frubem/Delta_Redux_KB/docs/kb_II.pdf

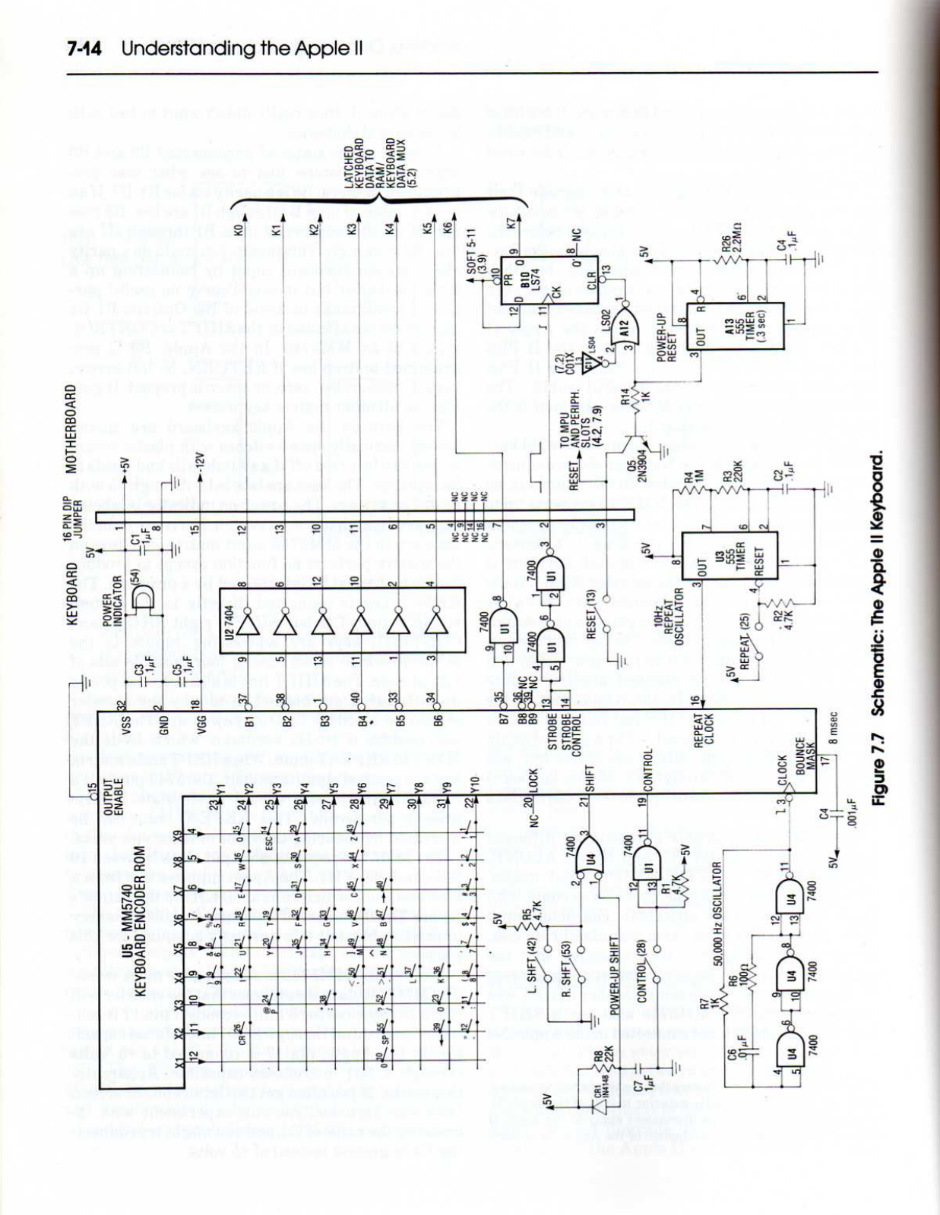
[picture p2: page 1]
