frubem/Delta_Redux_KB/docs/kb_IIp.pdf

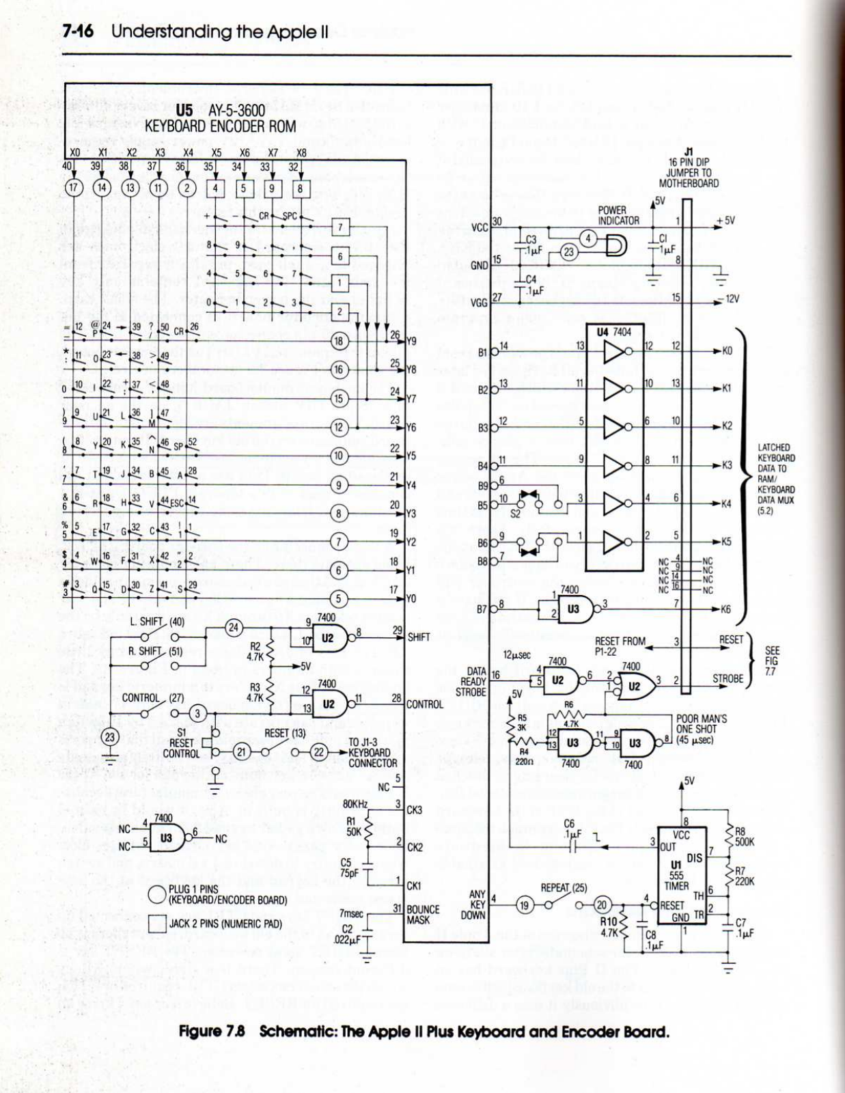
[picture p3: page 1]
