frubem/Delta_Redux_KB/docs/scancodes.pdf

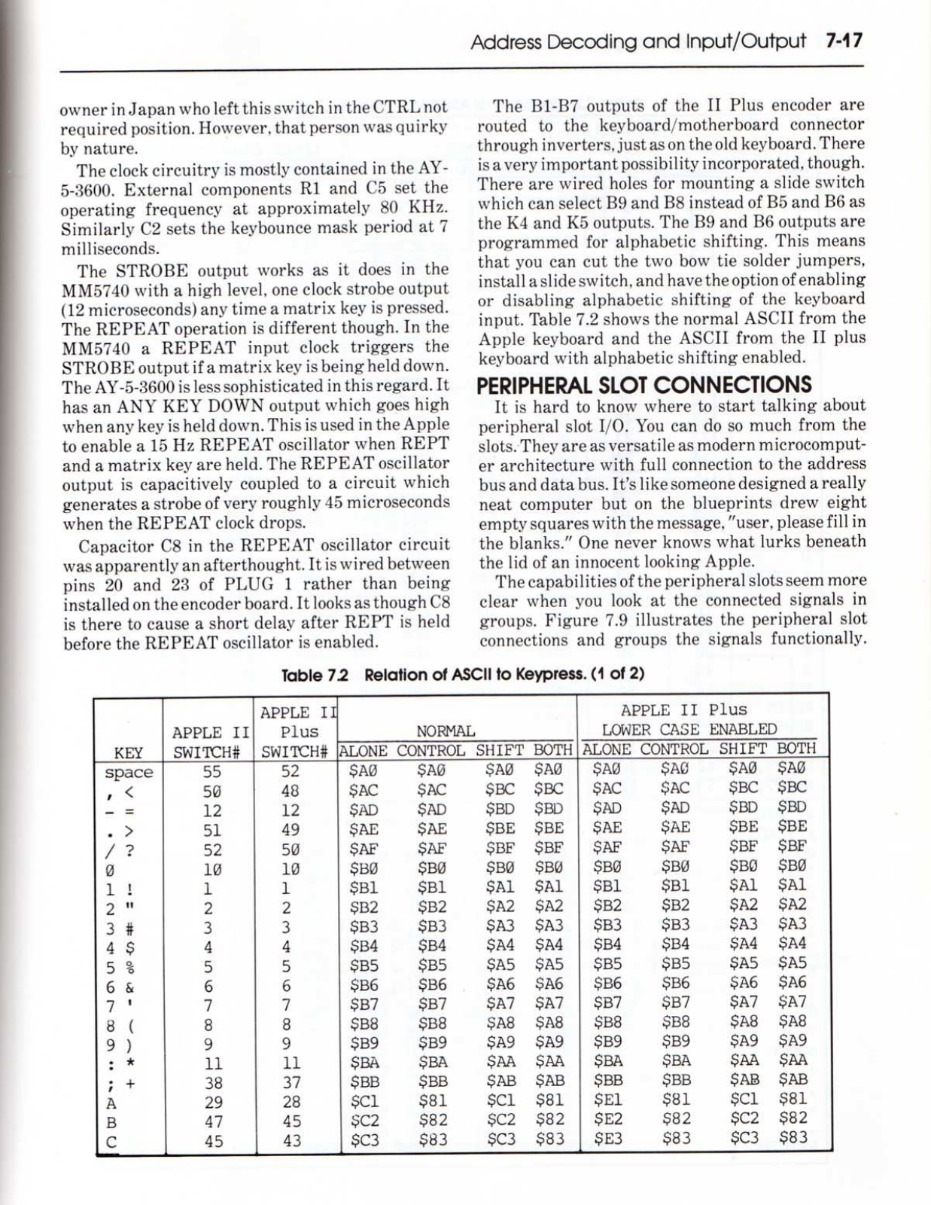
[picture p4: page 1]
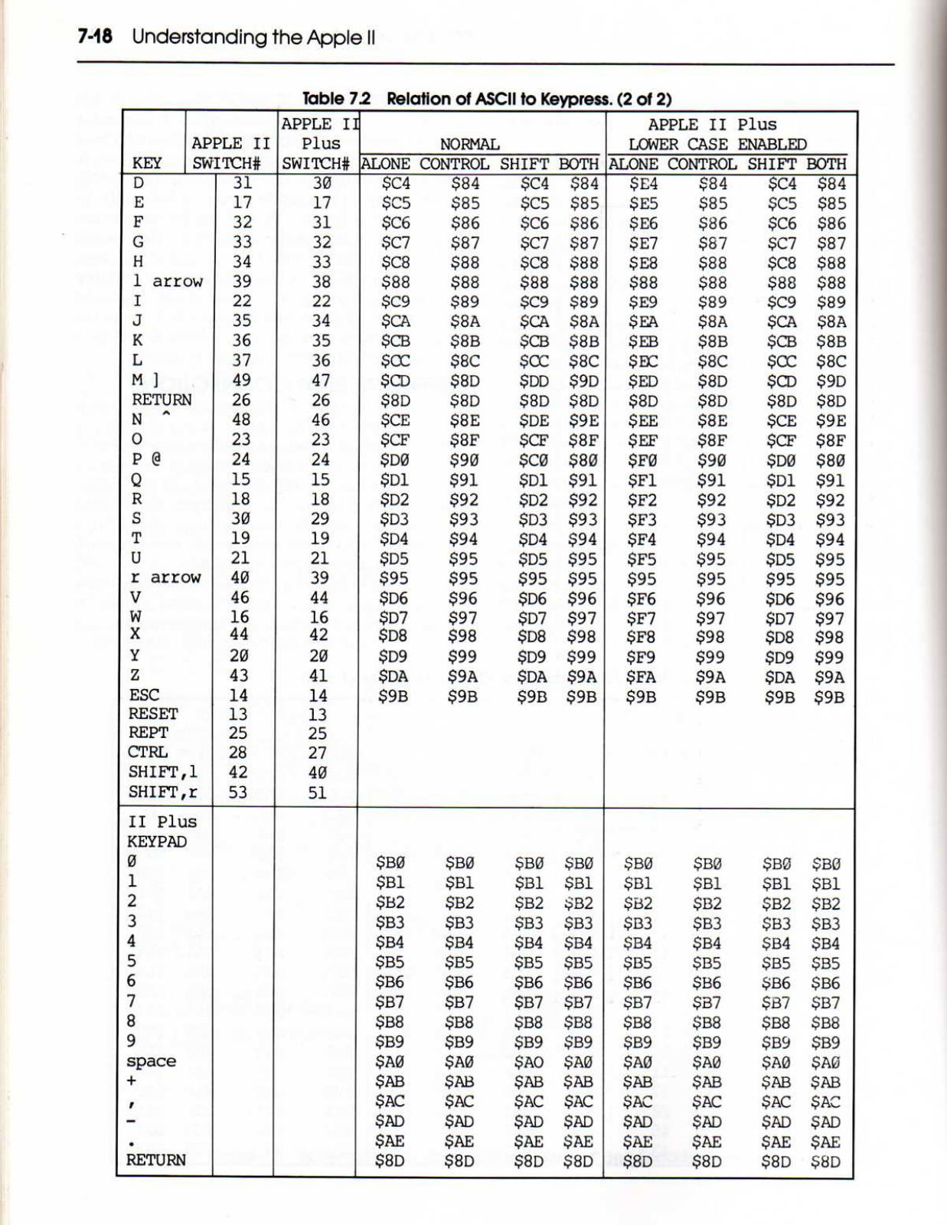
[picture p5: page 2]
