frubem/Delta_Redux_KB/docs/scancodes_IIe.pdf

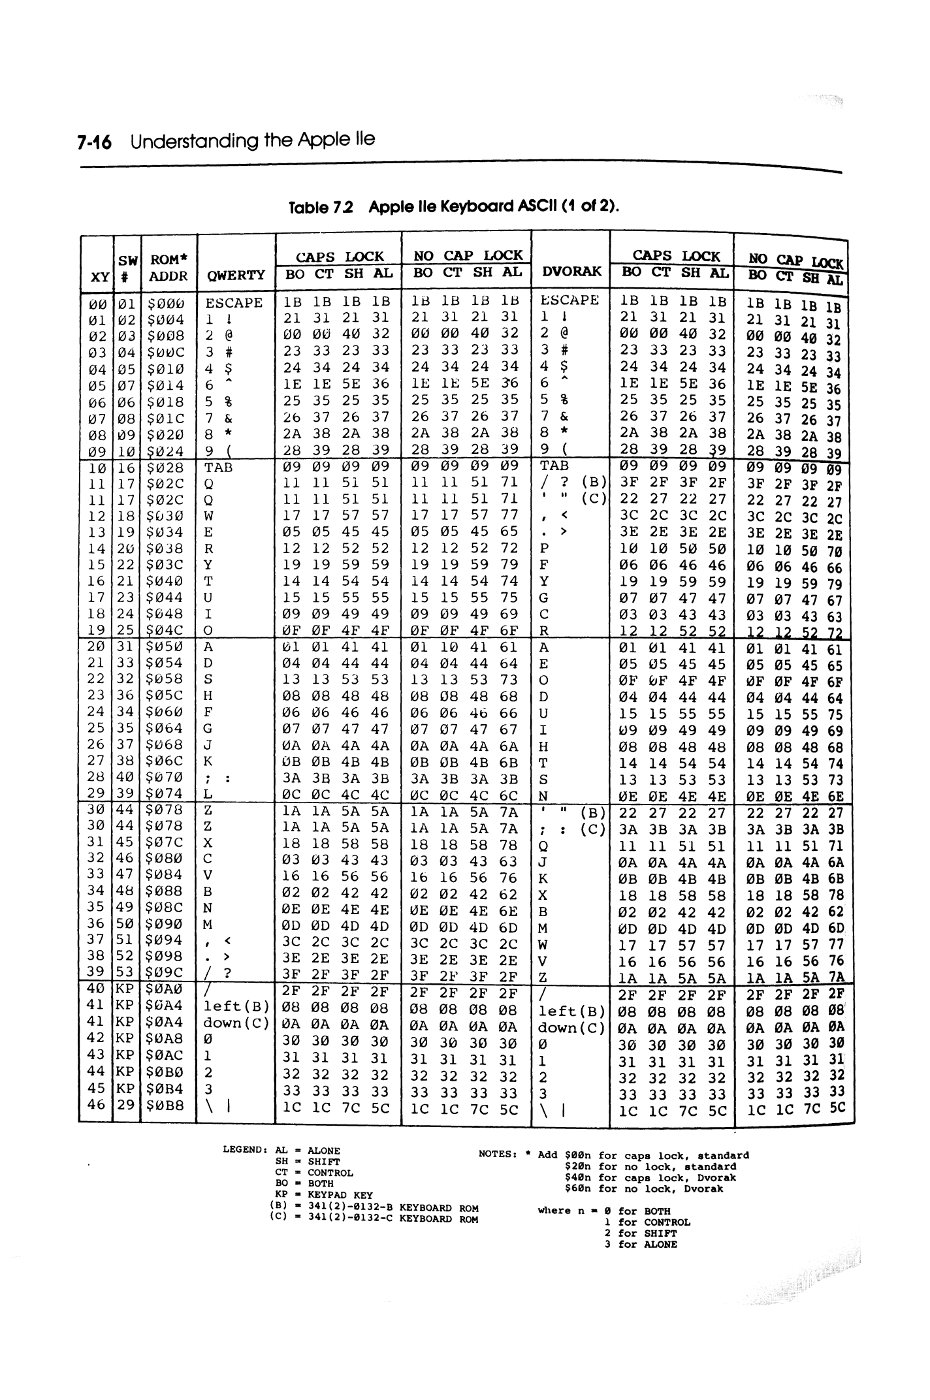
[picture p6: page 1]
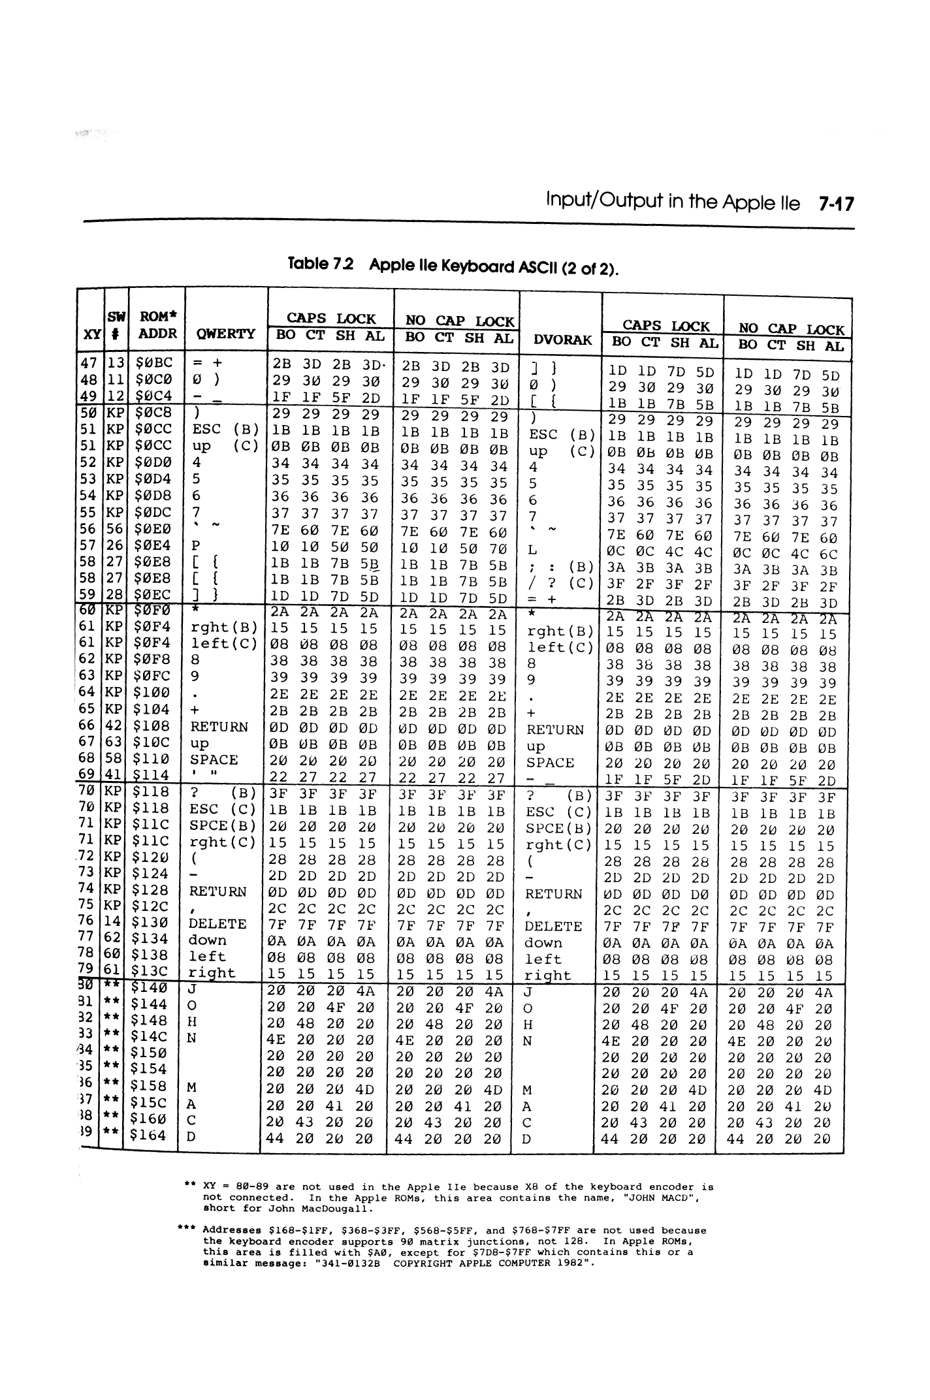
[picture p7: page 2]
