frubem/Delta_Redux_KB/docs/66226900-eb1e3e00-e6a9-11e9-80fa-fce8996ba06b.png

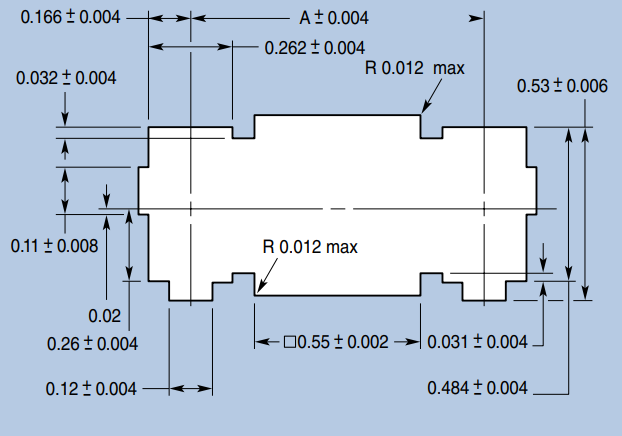
docs/66226900-eb1e3e00-e6a9-11e9-80fa-fce8996ba06b.png
