frubem/Delta_Redux_KB/docs/458601674548631436.png

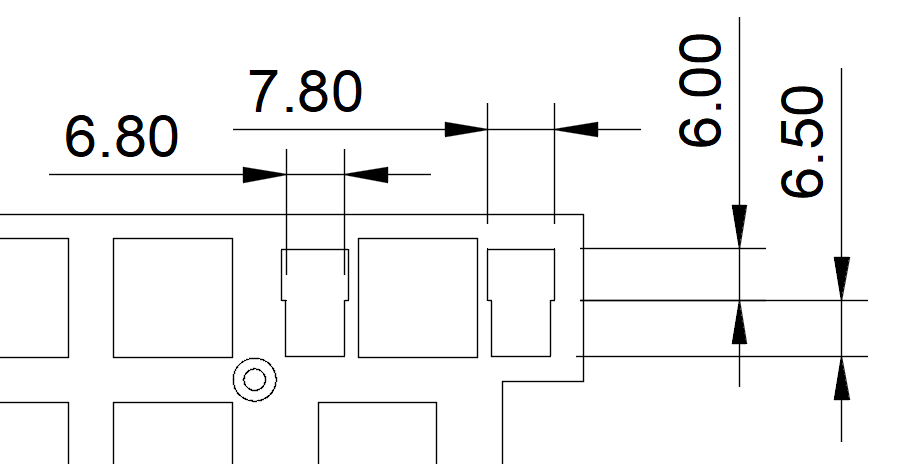
docs/458601674548631436.png
