frubem/Delta_Redux_KB/docs/apple-iie-complete-keyboard-cable_1_1bfa846138645f67741d17baa9bc94cb-2688188977.jpg

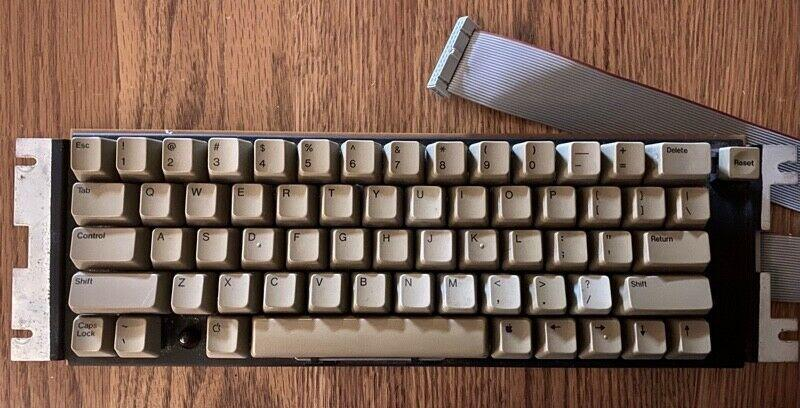
docs/apple-iie-complete-keyboard-cable_1_1bfa846138645f67741d17baa9bc94cb-2688188977.jpg
