frubem/Delta_Redux_KB/docs/apple_iie-italian_keyboard_layout-4271909959.jpg

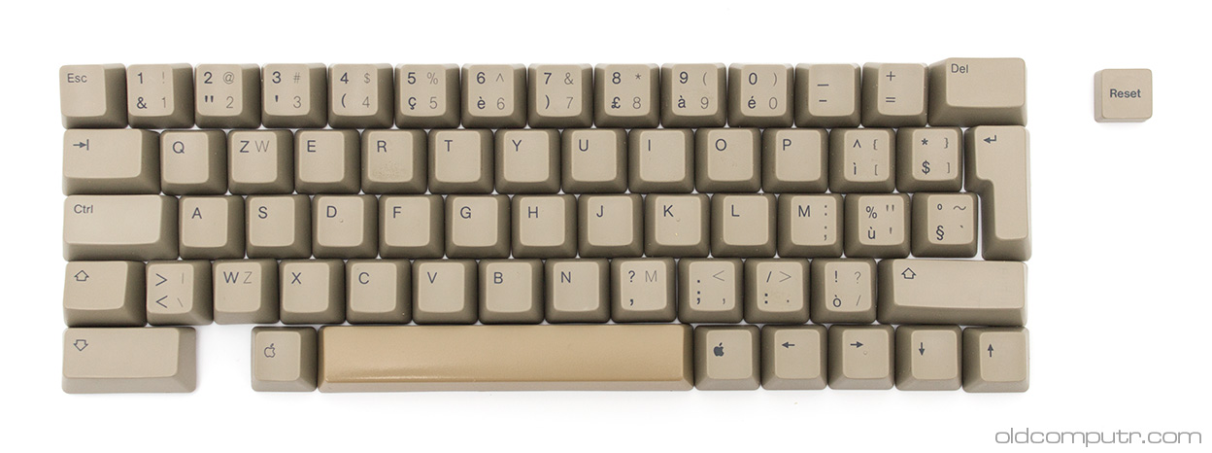
docs/apple_iie-italian_keyboard_layout-4271909959.jpg
