frubem/Delta_Redux_KB/docs/Apple_IIe_keyboard_f91f4-1661313939.jpg

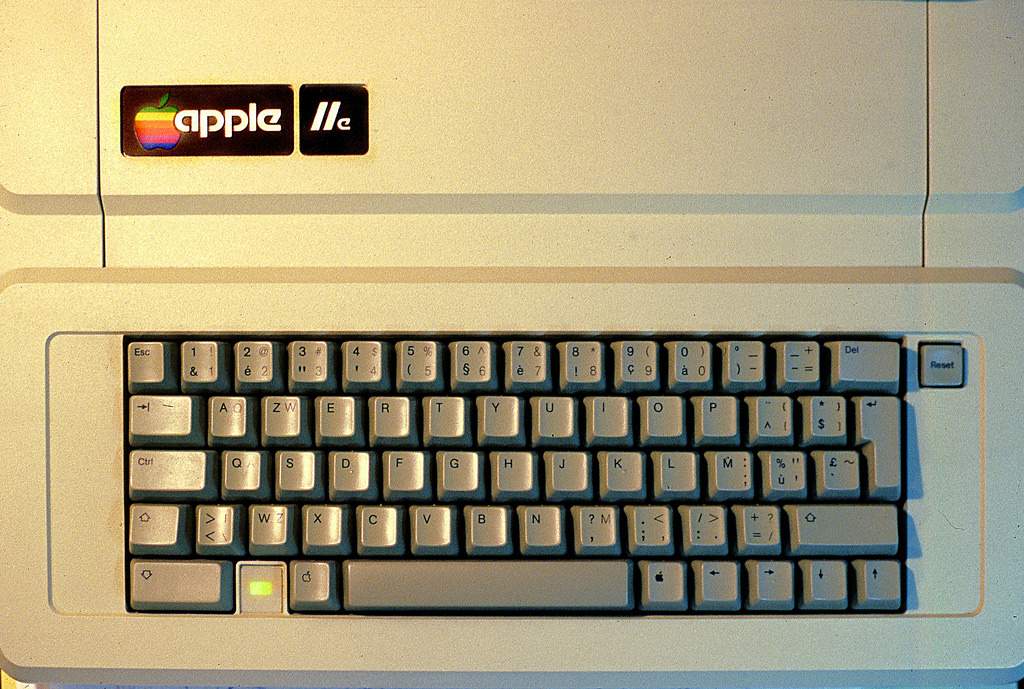
docs/Apple_IIe_keyboard_f91f4-1661313939.jpg
