frubem/Delta_Redux_KB/docs/AppleIIeE-8L.jpg

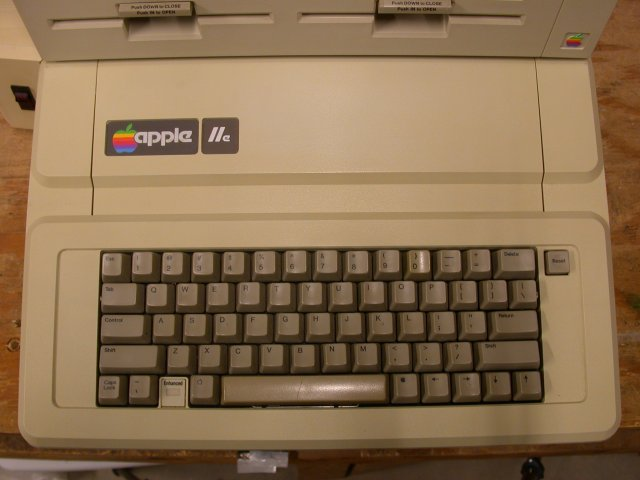
docs/AppleIIeE-8L.jpg
