frubem/Delta_Redux_KB/docs/dataneticskeyboardschematic.png

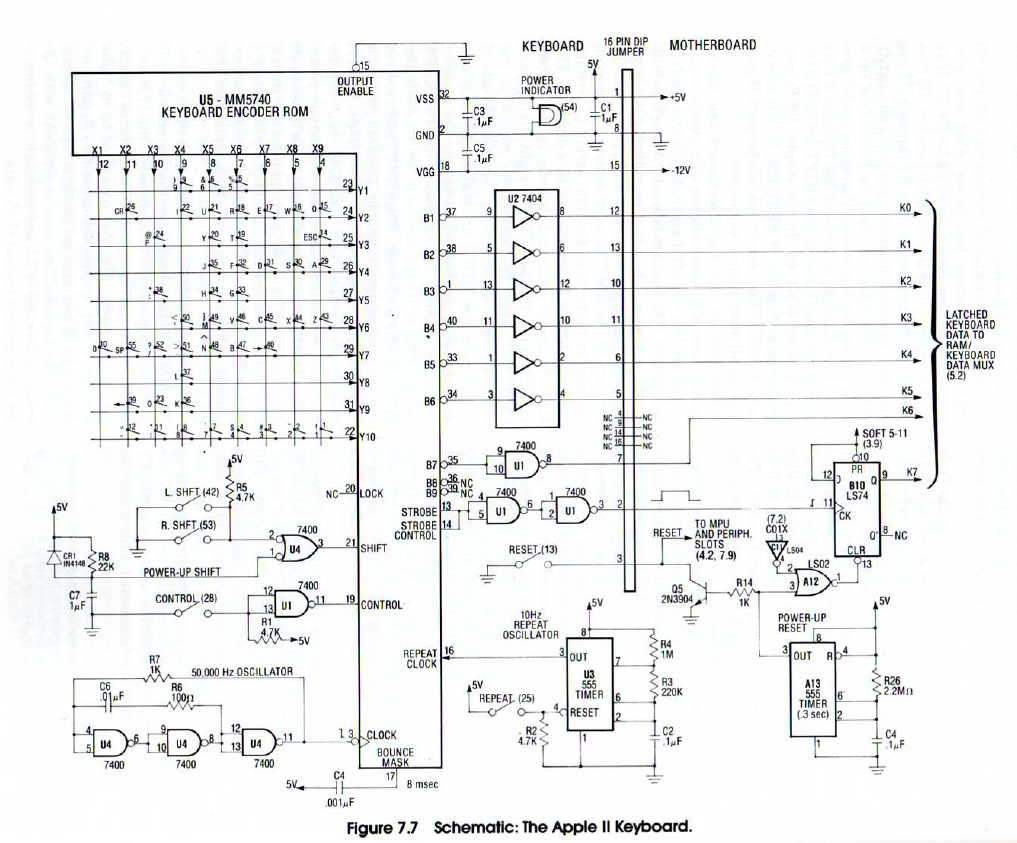
docs/dataneticskeyboardschematic.png
