frubem/Delta_Redux_KB/docs/mm5740ascii.webp

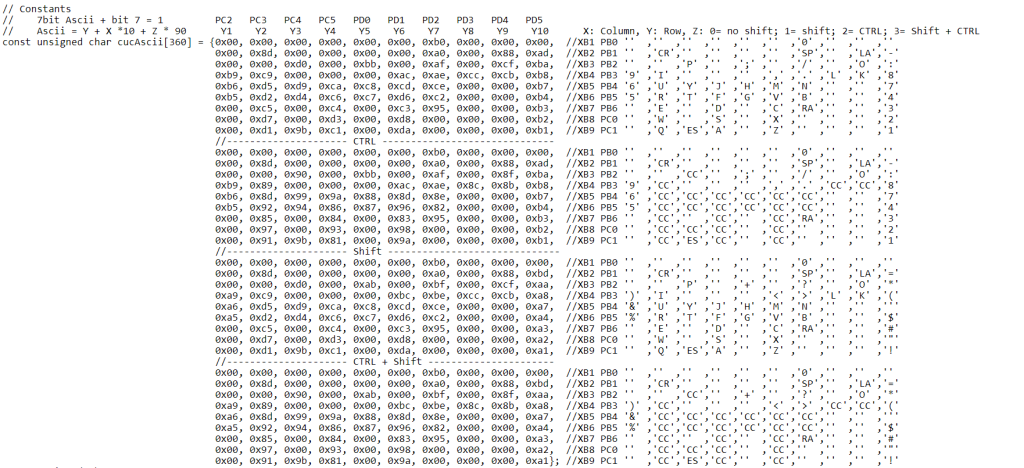
docs/mm5740ascii.webp
