frubem/Delta_Redux_KB/docs/VINTAGE-Apple-II-II-IIe-Numeric-Keypad-Fantastic-Condition-2105828752.webp

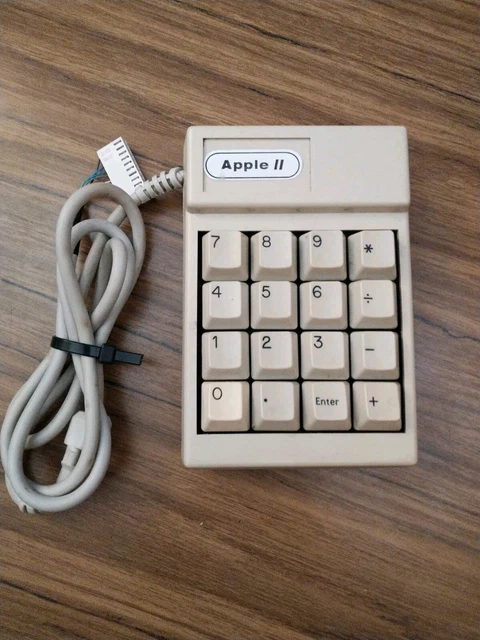
docs/VINTAGE-Apple-II-II-IIe-Numeric-Keypad-Fantastic-Condition-2105828752.webp
