frubem/Delta_Redux_KB/fw/fuses.jpg

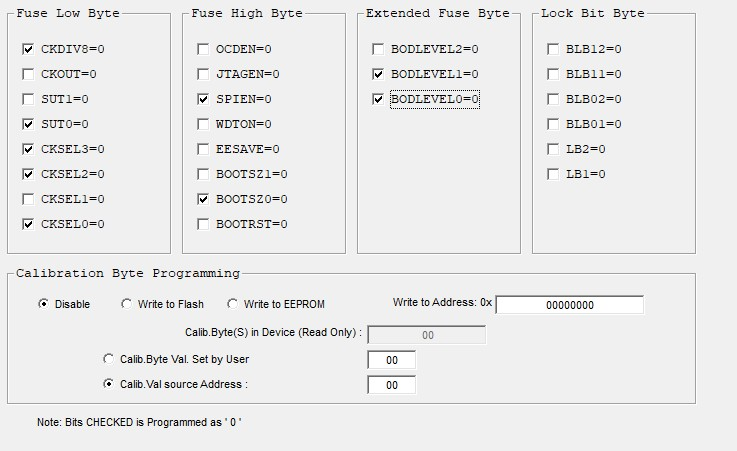
fw/fuses.jpg
