frubem/Delta_Redux_KB/graphics/top_kb.png

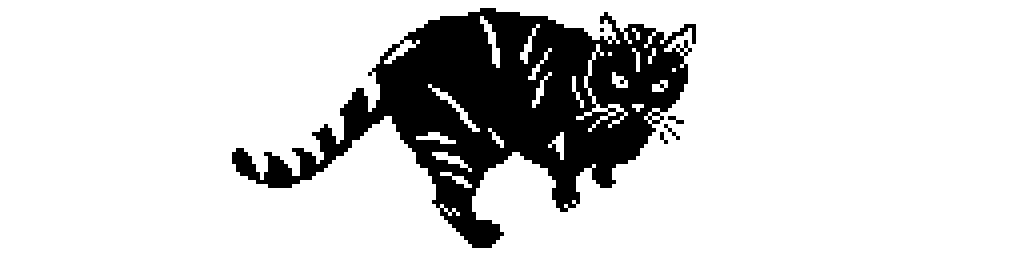
graphics/top_kb.png
