frubem/Delta_Redux_KB/keyboard/fixes.md

# Keyboard base: Required fixes

## Rev. 0

All of these fixes have been included in Rev.1

### R9 resistor value

Replace R9 resistor with an 1K one (silkscreen says 4.7K)

### Additional capacitor for caps-lock debounce circuit

Bodge a 10uF/25V+ MLCC capacitor between pin 1 of U4 and GND (refer to picture below)

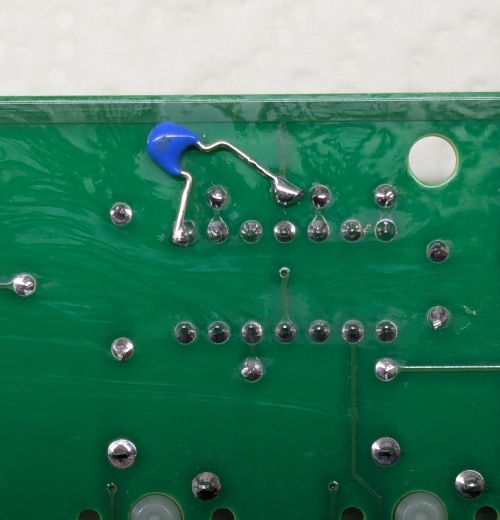
[picture p19: keyboard/pics/rev_0_debounce_cap.jpg]
10uF capacitor bodged on the underside of the PCB, between pin 1 of U4 and GND


### Current limiting resistor for caps-lock

This may be a bit on the paranoid side, but, to limit current inrush when the caps-lock switch is closed, a small-ish
(150 ohm) reistor must be added in series to the switch.

Cut the trace on the underside of the board, running from pin 1 of SW56 (the caps-lock switch) and GND. Also, scrape
some solder mask on the sides of the cut.

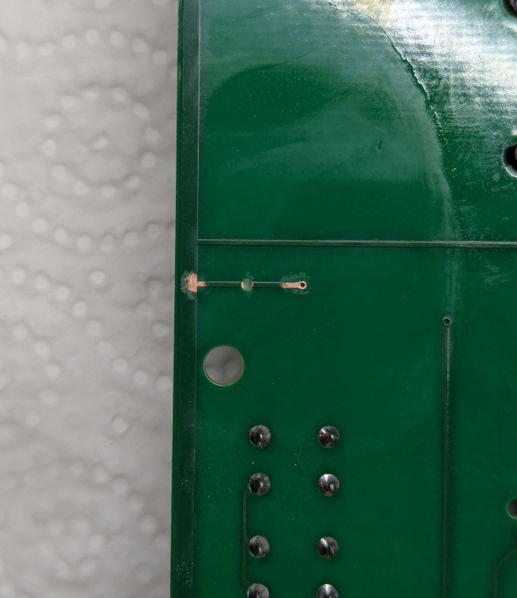
[picture p20: keyboard/pics/rev_0_capslock_cut.jpg]
Cut in the middle of a trace connecting pin 1 of SW56 and GND, the track was scraped on the sides of the cut


Trim the legs on a small resistor, value around 150 ohm, and solder the resistor on the scraped copper.

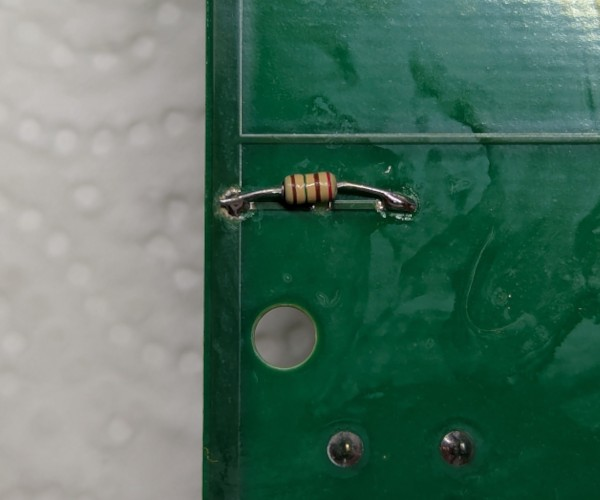
[picture p21: keyboard/pics/rev_0_capslock_resistor.jpg]
150 ohm resistor soldered on the two sides of the cut trace


### Missing link for Y7 column on numpad connector

Bodge a wire between pin 7 of J3 and pin 1 of SW6 (refer to picture below)

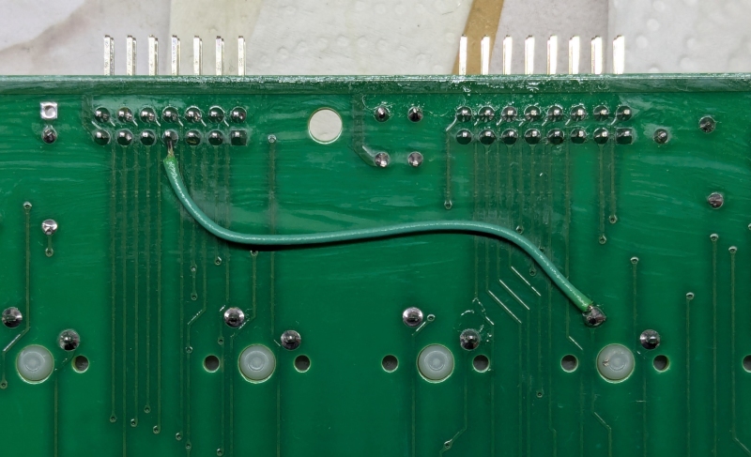
[picture p22: keyboard/pics/rev_0_bodge_wire.jpg]
Bodge wire on underside of PCB, between pin 7 of J3 and pin 1 of SW6
