frubem/Delta_Redux_KB/keyboard/DELTA_Redux_KB.pdf

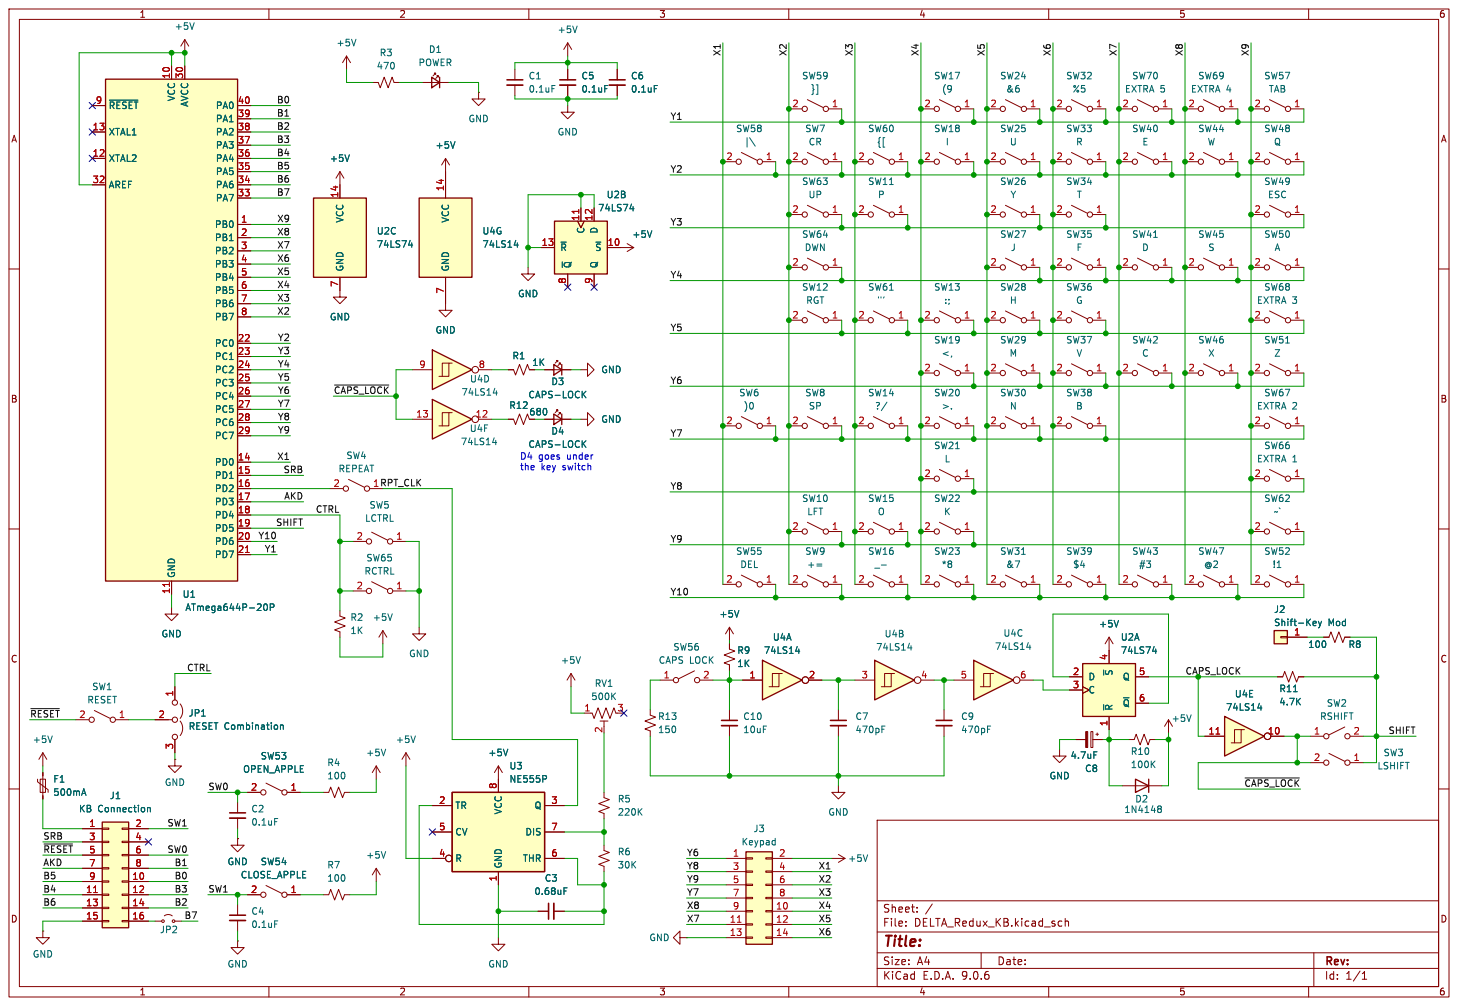
[picture p23: page 1]

D3 CAPS-LOCK D4 CAPS-LOCK GND

Id: 1/1 Title: File: DELTA_Redux_KB.kicad_sch Sheet: /
