frubem/Delta_Redux_KB/numpad/DELTA_Redux_Numpad.kicad_pcb

## KiCad design numpad/DELTA_Redux_Numpad.kicad_pcb (2026-08-03)

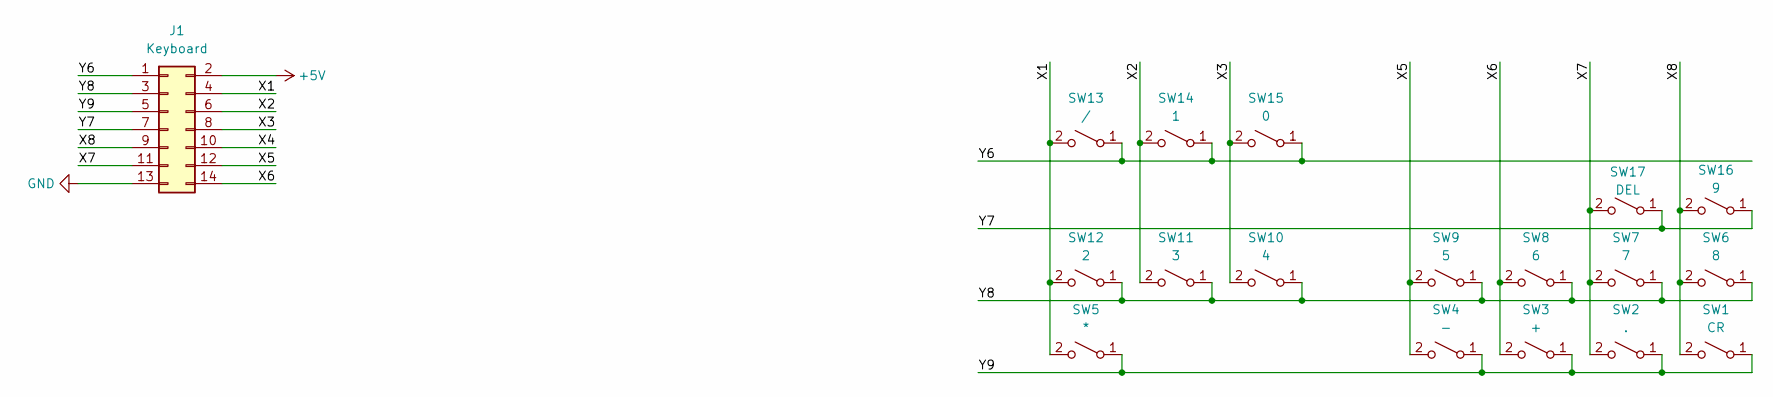
[picture p24: schematic DELTA_Redux_Numpad.kicad_sch]

Parts:
J1: Keyboard; PinHeader_2x07_P2.54mm_Horizontal
SW1: CR; SW_Cherry_MX_2.00u_PCB
SW2: .; SW_Cherry_MX_1.00u_PCB
SW3: +; SW_Cherry_MX_2.00u_PCB
SW4: -; SW_Cherry_MX_1.00u_PCB
SW5: *; SW_Cherry_MX_1.00u_PCB
SW6: 8; SW_Cherry_MX_1.00u_PCB
SW7: 7; SW_Cherry_MX_1.00u_PCB
SW8: 6; SW_Cherry_MX_1.00u_PCB
SW9: 5; SW_Cherry_MX_1.00u_PCB
SW10: 4; SW_Cherry_MX_1.00u_PCB
SW11: 3; SW_Cherry_MX_1.00u_PCB
SW12: 2; SW_Cherry_MX_1.00u_PCB
SW13: /; SW_Cherry_MX_1.00u_PCB
SW14: 1; SW_Cherry_MX_1.00u_PCB
SW15: 0; SW_Cherry_MX_2.00u_PCB
SW16: 9; SW_Cherry_MX_1.00u_PCB
SW17: DEL; SW_Cherry_MX_1.00u_PCB

Connections:
+5V: J1.2
/X1: J1.4, SW5.2 (B), SW12.2 (B), SW13.2 (B)
/X2: J1.6, SW11.2 (B), SW14.2 (B)
/X3: J1.8, SW10.2 (B), SW15.2 (B)
/X4: J1.10
/X5: J1.12, SW4.2 (B), SW9.2 (B)
/X6: J1.14, SW3.2 (B), SW8.2 (B)
/X7: J1.11, SW2.2 (B), SW7.2 (B), SW17.2 (B)
/X8: J1.9, SW1.2 (B), SW6.2 (B), SW16.2 (B)
/Y6: J1.1, SW13.1 (A), SW14.1 (A), SW15.1 (A)
/Y7: J1.7, SW16.1 (A), SW17.1 (A)
/Y8: J1.3, SW6.1 (A), SW7.1 (A), SW8.1 (A), SW9.1 (A), SW10.1 (A), SW11.1 (A), SW12.1 (A)
/Y9: J1.5, SW1.1 (A), SW2.1 (A), SW3.1 (A), SW4.1 (A), SW5.1 (A)
GND: J1.13

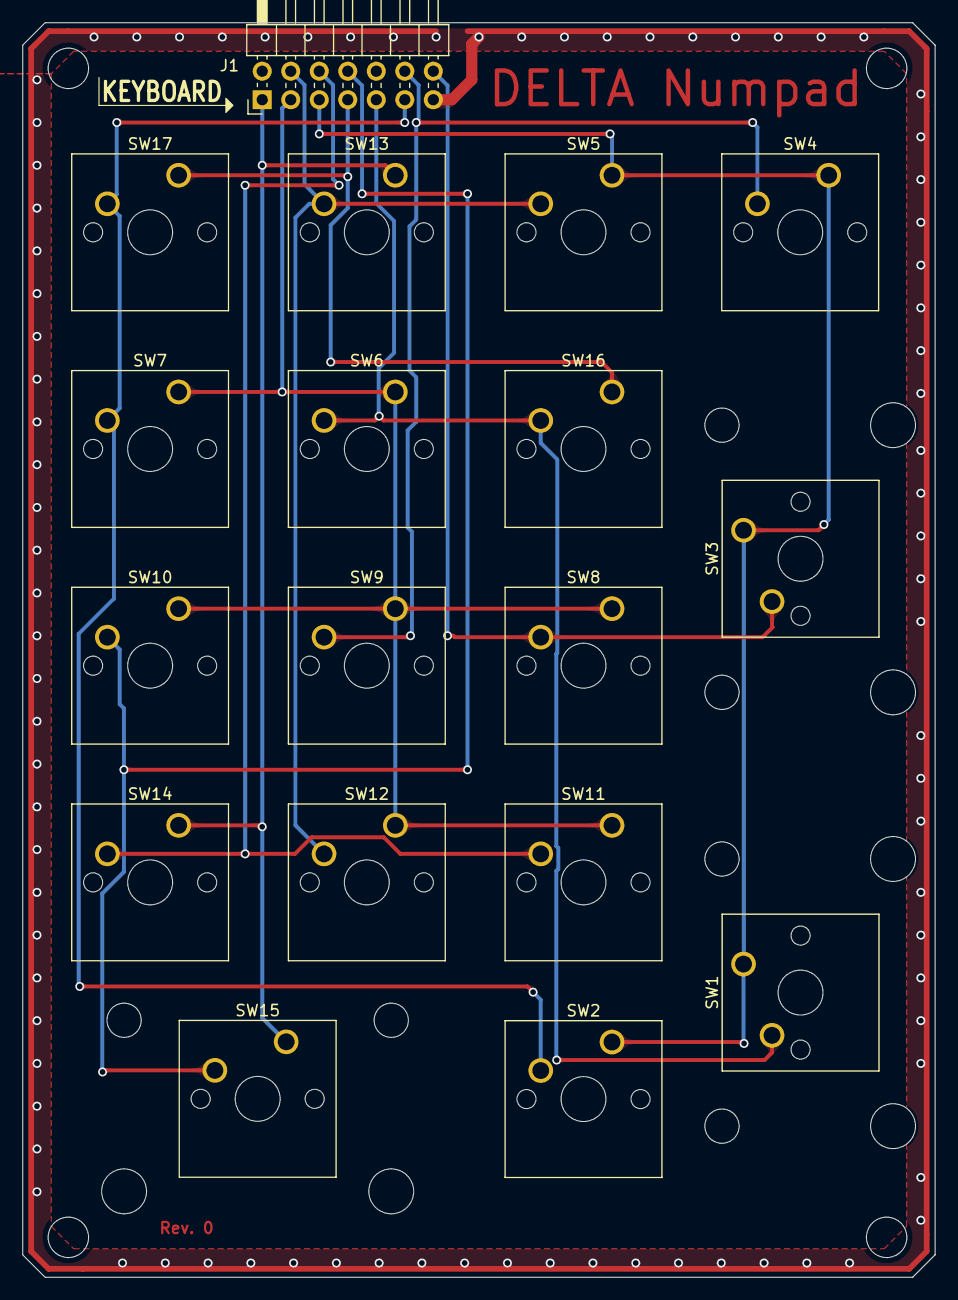
[picture p25: board DELTA_Redux_Numpad.kicad_pcb from above]

Board: 2 copper layers, 81.3 x 111.8 mm, 18 parts (0 on the bottom side), 11 nets.
