frubem/Delta_Redux_KB/keyboard/DELTA_Redux_KB.kicad_pcb

## KiCad design keyboard/DELTA_Redux_KB.kicad_pcb (2026-08-03)

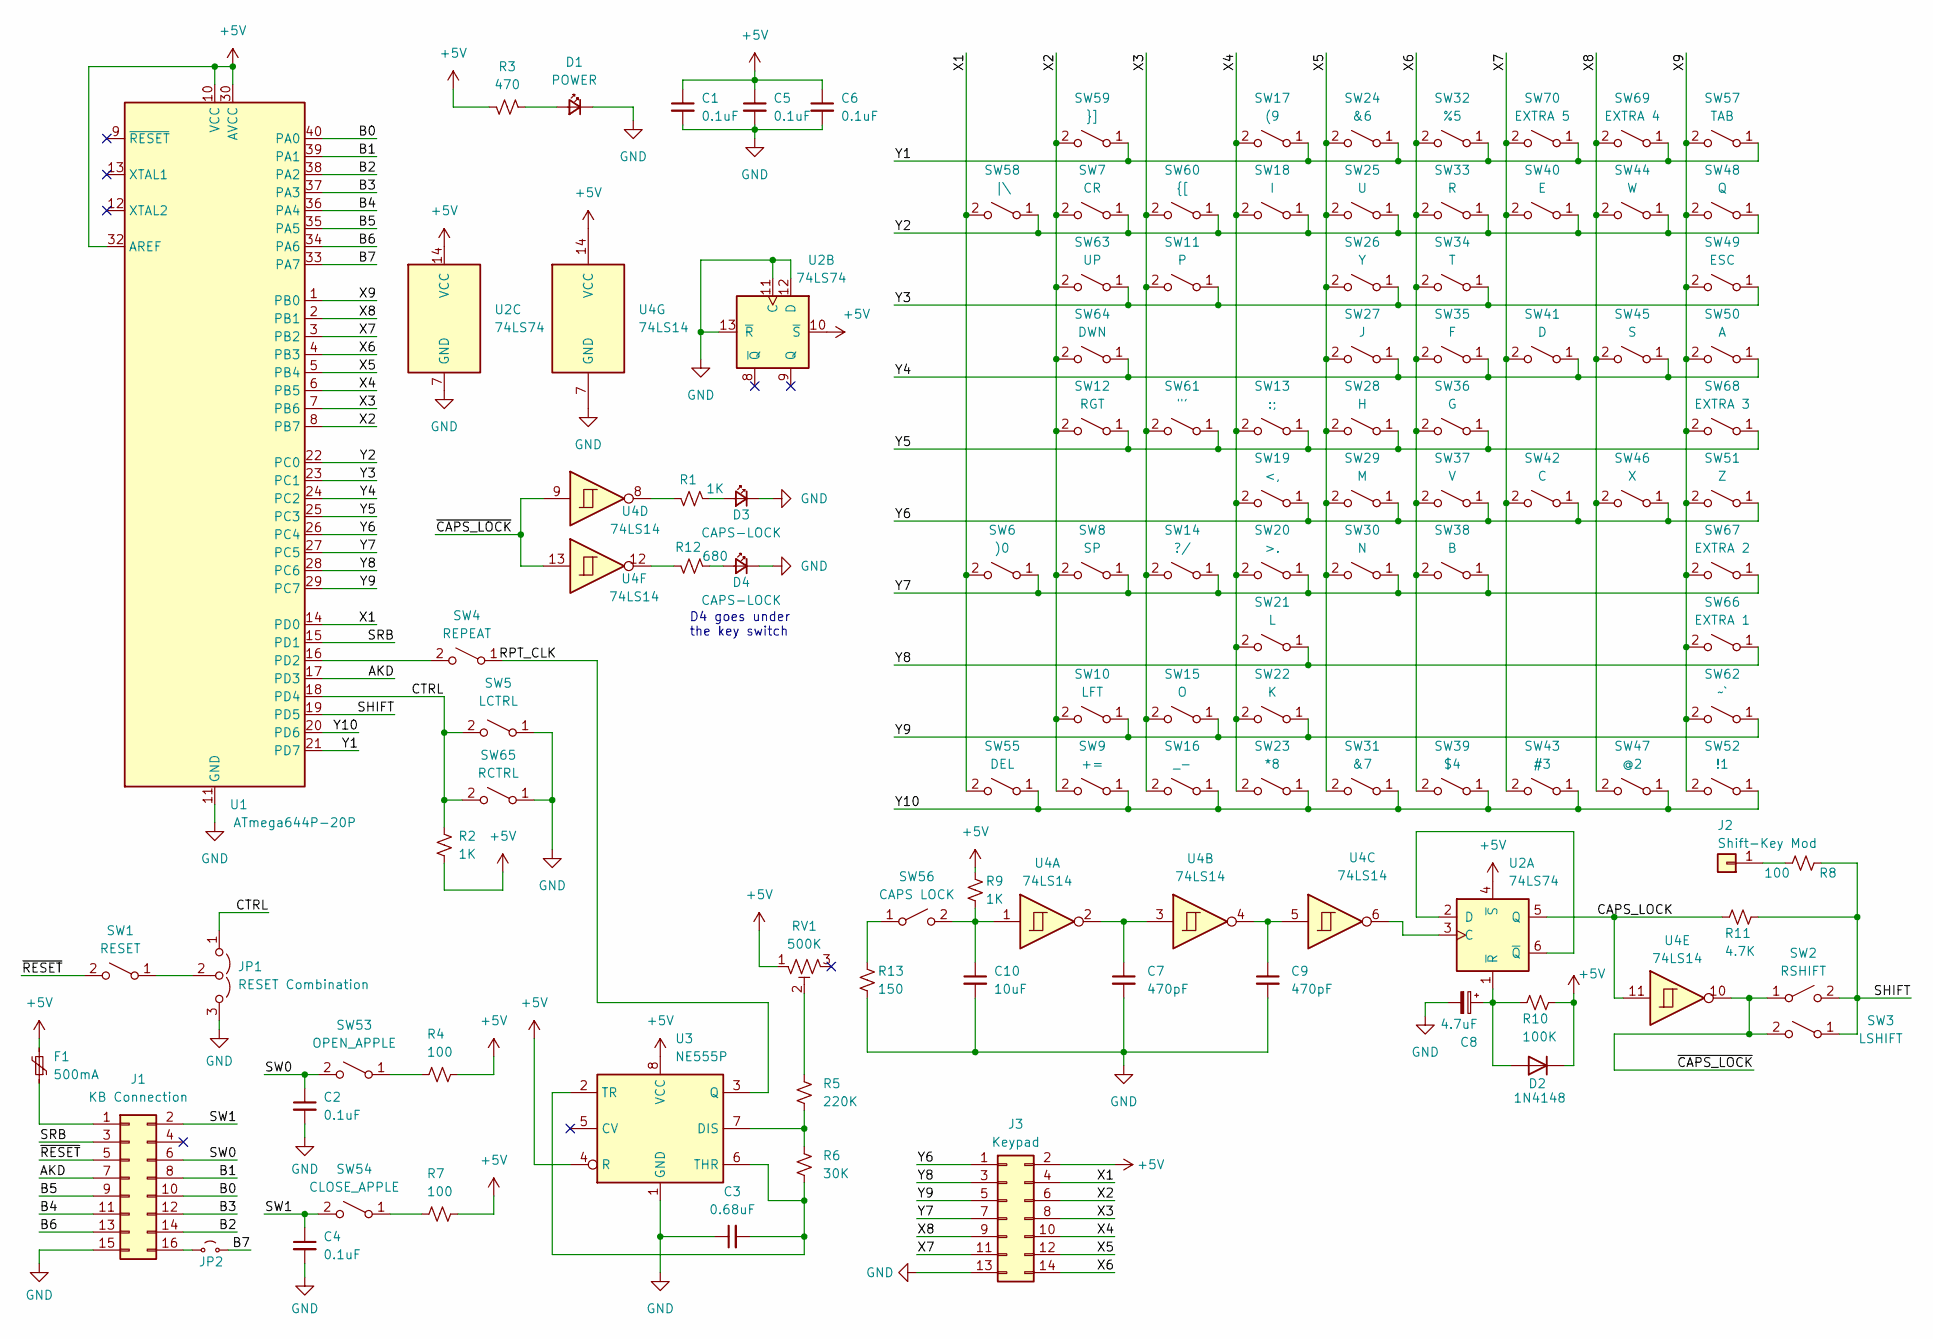
[picture p26: schematic DELTA_Redux_KB.kicad_sch]

Parts:
C1, C2, C4, C5, C6: 0.1uF; C_Disc_D5.0mm_W2.5mm_P5.00mm
C3: 0.68uF; C_Disc_D5.0mm_W2.5mm_P5.00mm
C7, C9: 470pF; C_Disc_D5.0mm_W2.5mm_P5.00mm
C8: 4.7uF; CP_Radial_D5.0mm_P2.50mm
C10: 10uF; C_Disc_D5.0mm_W2.5mm_P5.00mm
D1: POWER; LED_D5.0mm
D2: 1N4148; D_DO-35_SOD27_P10.16mm_Horizontal
D3: CAPS-LOCK; LED_D5.0mm
D4: CAPS-LOCK; LED_0603_1608Metric
F1: 500mA; Fuse_Bourns_MF-RHT070
J1: KB Connection; PinHeader_2x08_P2.54mm_Horizontal
J2: Shift-Key Mod; PinSocket_1x01_P2.54mm_Vertical
J3: Keypad; PinHeader_2x07_P2.54mm_Horizontal
JP1: RESET Combination; PinHeader_1x03_P2.54mm_Horizontal
JP2: Pass B8; PinSocket_1x02_P2.54mm_Vertical
R1, R2, R9: 1K; R_Axial_DIN0207_L6.3mm_D2.5mm_P10.16mm_Horizontal
R3: 470; R_Axial_DIN0207_L6.3mm_D2.5mm_P10.16mm_Horizontal
R4, R7, R8: 100; R_Axial_DIN0207_L6.3mm_D2.5mm_P10.16mm_Horizontal
R5: 220K; R_Axial_DIN0207_L6.3mm_D2.5mm_P10.16mm_Horizontal
R6: 30K; R_Axial_DIN0207_L6.3mm_D2.5mm_P10.16mm_Horizontal
R10: 100K; R_Axial_DIN0207_L6.3mm_D2.5mm_P10.16mm_Horizontal
R11: 4.7K; R_Axial_DIN0207_L6.3mm_D2.5mm_P10.16mm_Horizontal
R12: 680; R_Axial_DIN0207_L6.3mm_D2.5mm_P10.16mm_Horizontal
R13: 150; R_Axial_DIN0207_L6.3mm_D2.5mm_P10.16mm_Horizontal
RV1: 500K; Potentiometer_Bourns_3386F_Vertical
SW1: RESET; SW_Cherry_MX_1.00u_PCB
SW2: RSHIFT; SW_Cherry_MX_1.25u_PCB
SW3: LSHIFT; SW_Cherry_MX_2.25u_PCB
SW4: REPEAT; SW_Cherry_MX_1.00u_PCB
SW5: LCTRL; SW_Cherry_MX_1.50u_PCB
SW6: )0; SW_Cherry_MX_1.00u_PCB
SW7: CR; SW_Cherry_MX_1.75u_PCB
SW8: SP; SW_Cherry_MX_6.25u_PCB
SW9: +=; SW_Cherry_MX_1.00u_PCB
SW10: LFT; SW_Cherry_MX_1.00u_PCB
SW11: P; SW_Cherry_MX_1.00u_PCB
SW12: RGT; SW_Cherry_MX_1.00u_PCB
SW13: :;; SW_Cherry_MX_1.00u_PCB
SW14: ?/; SW_Cherry_MX_1.00u_PCB
SW15: O; SW_Cherry_MX_1.00u_PCB
SW16: _-; SW_Cherry_MX_1.00u_PCB
SW17: (9; SW_Cherry_MX_1.00u_PCB
SW18: I; SW_Cherry_MX_1.00u_PCB
SW19: <,; SW_Cherry_MX_1.00u_PCB
SW20: >.; SW_Cherry_MX_1.00u_PCB
SW21: L; SW_Cherry_MX_1.00u_PCB
SW22: K; SW_Cherry_MX_1.00u_PCB
SW23: *8; SW_Cherry_MX_1.00u_PCB
SW24: &6; SW_Cherry_MX_1.00u_PCB
SW25: U; SW_Cherry_MX_1.00u_PCB
SW26: Y; SW_Cherry_MX_1.00u_PCB
SW27: J; SW_Cherry_MX_1.00u_PCB
SW28: H; SW_Cherry_MX_1.00u_PCB
SW29: M; SW_Cherry_MX_1.00u_PCB
SW30: N; SW_Cherry_MX_1.00u_PCB
SW31: &7; SW_Cherry_MX_1.00u_PCB
SW32: %5; SW_Cherry_MX_1.00u_PCB
SW33: R; SW_Cherry_MX_1.00u_PCB
SW34: T; SW_Cherry_MX_1.00u_PCB
SW35: F; SW_Cherry_MX_1.00u_PCB
SW36: G; SW_Cherry_MX_1.00u_PCB
SW37: V; SW_Cherry_MX_1.00u_PCB
SW38: B; SW_Cherry_MX_1.00u_PCB
SW39: $4; SW_Cherry_MX_1.00u_PCB
SW40: E; SW_Cherry_MX_1.00u_PCB
SW41: D; SW_Cherry_MX_1.00u_PCB
SW42: C; SW_Cherry_MX_1.00u_PCB
SW43: #3; SW_Cherry_MX_1.00u_PCB
SW44: W; SW_Cherry_MX_1.00u_PCB
SW45: S; SW_Cherry_MX_1.00u_PCB
SW46: X; SW_Cherry_MX_1.00u_PCB
SW47: @2; SW_Cherry_MX_1.00u_PCB
SW48: Q; SW_Cherry_MX_1.00u_PCB
SW49: ESC; SW_Cherry_MX_1.00u_PCB
SW50: A; SW_Cherry_MX_1.00u_PCB
SW51: Z; SW_Cherry_MX_1.00u_PCB
SW52: !1; SW_Cherry_MX_1.00u_PCB
SW53: OPEN_APPLE; SW_Cherry_MX_1.50u_PCB
SW54: CLOSE_APPLE; SW_Cherry_MX_1.50u_PCB
SW55: DEL; SW_Cherry_MX_1.50u_PCB
SW56: CAPS LOCK; SW_Cherry_MX_1.75u_PCB
SW57: TAB; SW_Cherry_MX_1.50u_PCB
SW58: |\; SW_Cherry_MX_1.00u_PCB
SW59: }]; SW_Cherry_MX_1.00u_PCB
SW60: {[; SW_Cherry_MX_1.00u_PCB
SW61: "'; SW_Cherry_MX_1.00u_PCB
SW62: ~`; SW_Cherry_MX_1.00u_PCB
SW63: UP; SW_Cherry_MX_1.00u_PCB
SW64: DWN; SW_Cherry_MX_1.00u_PCB
SW65: RCTRL; SW_Cherry_MX_1.50u_PCB
SW66: EXTRA 1; SW_PUSH_6mm_H4.3mm
SW67: EXTRA 2; SW_PUSH_6mm_H4.3mm
SW68: EXTRA 3; SW_PUSH_6mm_H4.3mm
SW69: EXTRA 4; SW_PUSH_6mm_H4.3mm
SW70: EXTRA 5; SW_PUSH_6mm_H4.3mm
U1: ATmega644P-20P; DIP-40_W15.24mm
U2: 74LS74; DIP-14_W7.62mm
U3: NE555P; DIP-8_W7.62mm
U4: 74LS14; DIP-14_W7.62mm

Connections:
+5V: C1.1, C5.1, C6.1, D2.1 (K), F1.2, J3.2, R2.1, R3.1, R4.1, R7.1, R9.2, R10.2, RV1.1, U1.10 (VCC), U1.30 (AVCC), U1.32 (AREF), U2.4 (~S), U2.10 (~S), U2.14 (VCC), U3.4 (R), U3.8 (VCC), U4.14 (VCC)
/AKD: J1.7, U1.17 (PD3)
/B0: J1.10, U1.40 (PA0)
/B1: J1.8, U1.39 (PA1)
/B2: J1.14, U1.38 (PA2)
/B3: J1.12, U1.37 (PA3)
/B4: J1.11, U1.36 (PA4)
/B5: J1.9, U1.35 (PA5)
/B6: J1.13, U1.34 (PA6)
/B7: JP2.2 (B), U1.33 (PA7)
/CAPS_LOCK: R11.1, U2.5 (Q), U4.11
/CTRL: JP1.1 (A), R2.2, SW5.2 (B), SW65.2 (B), U1.18 (PD4)
/RPT_CLK: SW4.1 (A), U3.3 (Q)
/SHIFT: R8.2, R11.2, SW2.2 (B), SW3.1 (A), U1.19 (PD5)
/SRB: J1.3, U1.15 (PD1)
/SW0: C2.1, J1.6, SW53.2 (B)
/SW1: C4.1, J1.2, SW54.2 (B)
/X1: J3.4, SW6.2 (B), SW55.2 (B), SW58.2 (B), U1.14 (PD0)
/X2: J3.6, SW7.2 (B), SW8.2 (B), SW9.2 (B), SW10.2 (B), SW12.2 (B), SW59.2 (B), SW63.2 (B), SW64.2 (B), U1.8 (PB7)
/X3: J3.8, SW11.2 (B), SW14.2 (B), SW15.2 (B), SW16.2 (B), SW60.2 (B), SW61.2 (B), U1.7 (PB6)
/X4: J3.10, SW13.2 (B), SW17.2 (B), SW18.2 (B), SW19.2 (B), SW20.2 (B), SW21.2 (B), SW22.2 (B), SW23.2 (B), U1.6 (PB5)
/X5: J3.12, SW24.2 (B), SW25.2 (B), SW26.2 (B), SW27.2 (B), SW28.2 (B), SW29.2 (B), SW30.2 (B), SW31.2 (B), U1.5 (PB4)
/X6: J3.14, SW32.2 (B), SW33.2 (B), SW34.2 (B), SW35.2 (B), SW36.2 (B), SW37.2 (B), SW38.2 (B), SW39.2 (B), U1.4 (PB3)
/X7: J3.11, SW40.2 (B), SW41.2 (B), SW42.2 (B), SW43.2 (B), SW70.2 (B), U1.3 (PB2)
/X8: J3.9, SW44.2 (B), SW45.2 (B), SW46.2 (B), SW47.2 (B), SW69.2 (B), U1.2 (PB1)
/X9: SW48.2 (B), SW49.2 (B), SW50.2 (B), SW51.2 (B), SW52.2 (B), SW57.2 (B), SW62.2 (B), SW66.2 (B), SW67.2 (B), SW68.2 (B), U1.1 (PB0)
/Y1: SW17.1 (A), SW24.1 (A), SW32.1 (A), SW57.1 (A), SW59.1 (A), SW69.1 (A), SW70.1 (A), U1.21 (PD7)
/Y2: SW7.1 (A), SW18.1 (A), SW25.1 (A), SW33.1 (A), SW40.1 (A), SW44.1 (A), SW48.1 (A), SW58.1 (A), SW60.1 (A), U1.22 (PC0)
/Y3: SW11.1 (A), SW26.1 (A), SW34.1 (A), SW49.1 (A), SW63.1 (A), U1.23 (PC1)
/Y4: SW27.1 (A), SW35.1 (A), SW41.1 (A), SW45.1 (A), SW50.1 (A), SW64.1 (A), U1.24 (PC2)
/Y5: SW12.1 (A), SW13.1 (A), SW28.1 (A), SW36.1 (A), SW61.1 (A), SW68.1 (A), U1.25 (PC3)
/Y6: J3.1, SW19.1 (A), SW29.1 (A), SW37.1 (A), SW42.1 (A), SW46.1 (A), SW51.1 (A), U1.26 (PC4)
/Y7: J3.7, SW6.1 (A), SW8.1 (A), SW14.1 (A), SW20.1 (A), SW30.1 (A), SW38.1 (A), SW67.1 (A), U1.27 (PC5)
/Y8: J3.3, SW21.1 (A), SW66.1 (A), U1.28 (PC6)
/Y9: J3.5, SW10.1 (A), SW15.1 (A), SW22.1 (A), SW62.1 (A), U1.29 (PC7)
/Y10: SW9.1 (A), SW16.1 (A), SW23.1 (A), SW31.1 (A), SW39.1 (A), SW43.1 (A), SW47.1 (A), SW52.1 (A), SW55.1 (A), U1.20 (PD6)
/~CAPS_LOCK: SW2.1 (A), SW3.2 (B), U4.9, U4.10, U4.13
/~RESET: J1.5, SW1.2 (B)
GND: C1.2, C2.2, C3.1, C4.2, C5.2, C6.2, C7.2, C8.2, C9.2, C10.2, D1.1 (K), D3.1 (K), D4.1 (K), J1.15, J3.13, JP1.3 (B), R13.1, SW5.1 (A), SW65.1 (A), U1.11 (GND), U1.31 (GND), U2.7 (GND), U2.11 (C), U2.12 (D), U2.13 (~R), U3.1 (GND), U4.7 (GND)
unnamed: C7.1, U4.2, U4.3
unnamed: C9.1, U4.4, U4.5
unnamed: D1.2 (A), R3.2
unnamed: C8.1, D2.2 (A), R10.1, U2.1 (~R)
unnamed: D3.2 (A), R1.2
unnamed: D4.2 (A), R12.2
unnamed: F1.1, J1.1
unnamed: J1.16, JP2.1 (A)
unnamed: J2.1, R8.1
unnamed: JP1.2 (C), SW1.1 (A)
unnamed: R1.1, U4.8
unnamed: R5.2, RV1.2
unnamed: R12.1, U4.12
unnamed: SW4.2 (B), U1.16 (PD2)
unnamed: R4.2, SW53.1 (A)
unnamed: R7.2, SW54.1 (A)
unnamed: R13.2, SW56.1 (A)
unnamed: C10.1, R9.1, SW56.2 (B), U4.1
unnamed: U2.3 (C), U4.6
unnamed: U2.2 (D), U2.6 (~Q)
unnamed: R5.1, R6.2, U3.7 (DIS)
unnamed: C3.2, R6.1, U3.2 (TR), U3.6 (THR)

Notes on the sheet:
D4 goes under the key switch

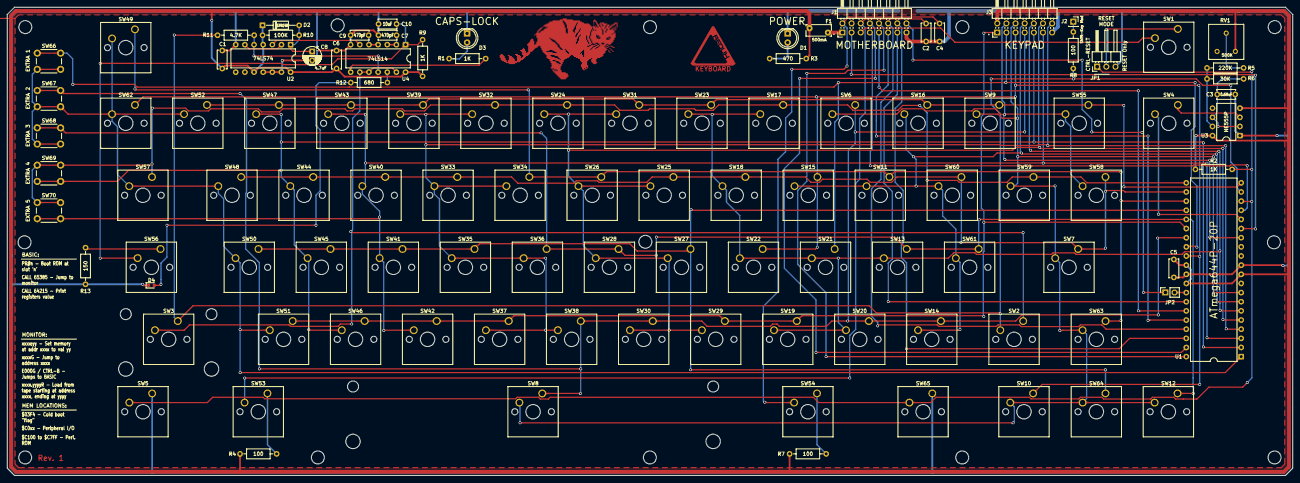
[picture p27: board DELTA_Redux_KB.kicad_pcb from above]

Board: 2 copper layers, 356.9 x 130.0 mm, 108 parts (0 on the bottom side), 61 nets.
